LiamNmbr1/2-Factor-Auth-Lock/Assem1.SLDASM

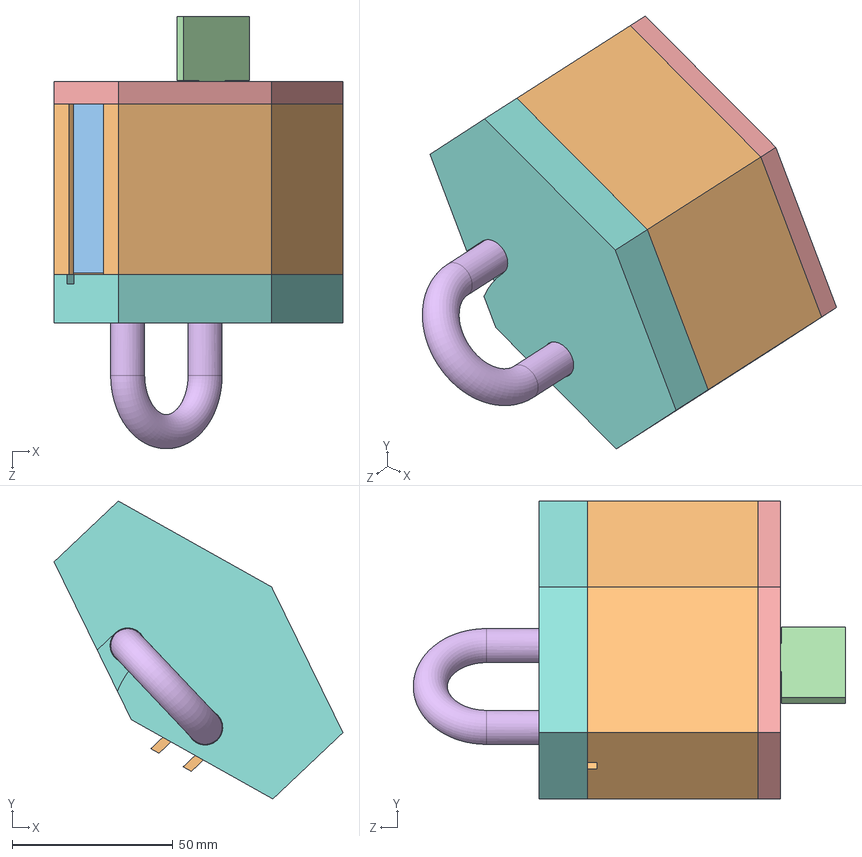
[picture p1: CAD file, 2026-10-18]
Assem1.SLDASM
89.8 x 92.6 x 134.3 mm
primary_rotator
secondary_rotator
Casing
plug_secondary_rotator
Cap_shackle
Slider_shackle
Shackle
Keyhole_cap
Key to unlock
Spring_cap
Shackle_pins
Pin_4mm
