LiamNmbr1/2-Factor-Auth-Lock/Shackle.SLDPRT

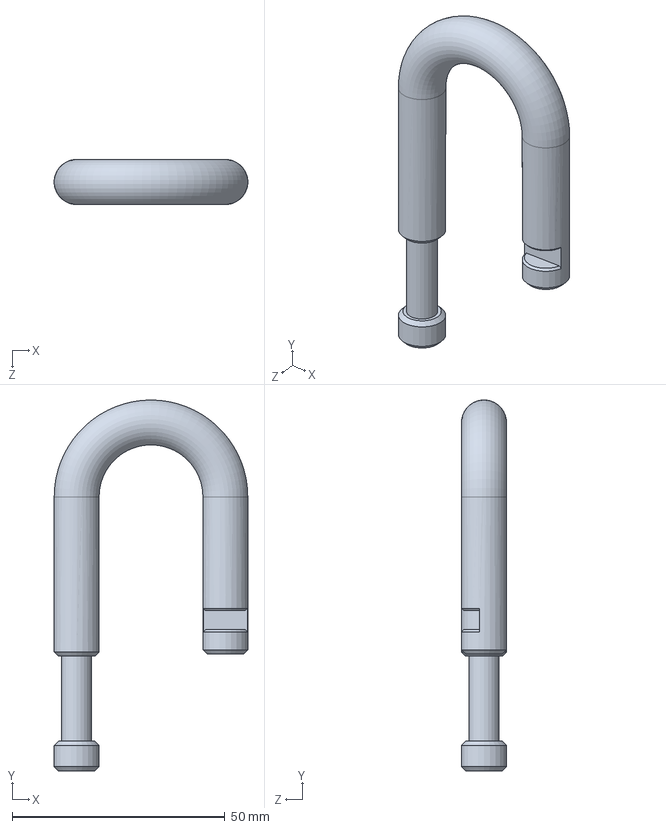
[picture p2: CAD file, 2026-10-18]
Shackle.SLDPRT
45.6 x 87.3 x 10.6 mm
