LiamNmbr1/2-Factor-Auth-Lock/Slider_shackle.SLDPRT

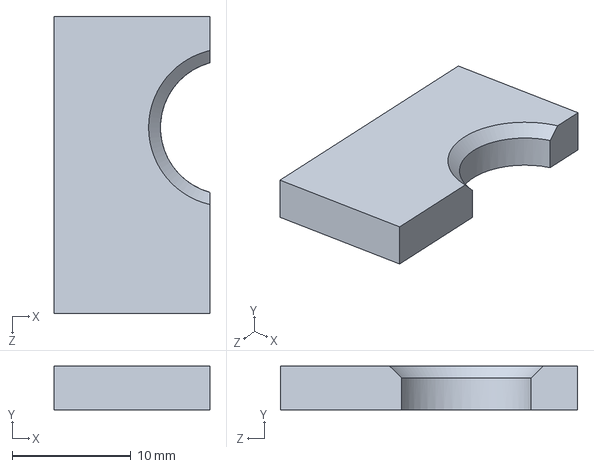
[picture p3: CAD file, 2026-10-18]
Slider_shackle.SLDPRT
13.1 x 3.70 x 25.0 mm
