LiamNmbr1/2-Factor-Auth-Lock/Pin_4mm.SLDPRT

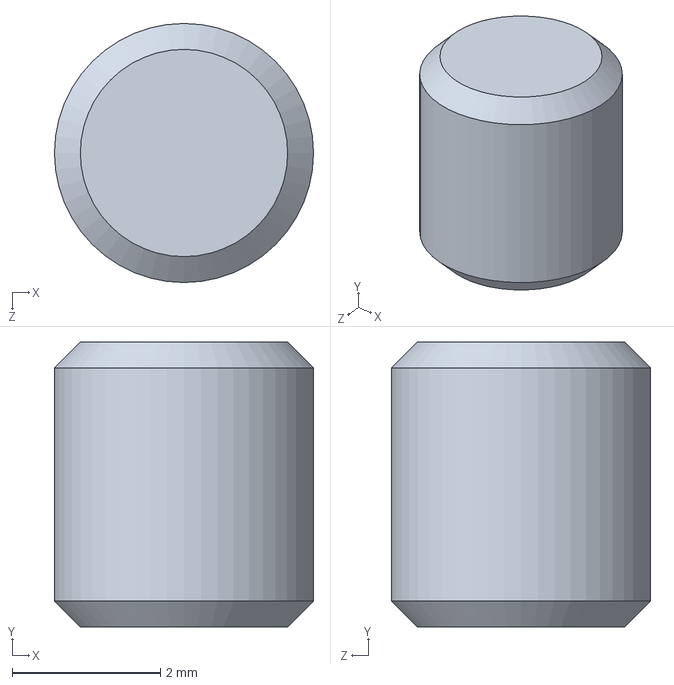
[picture p4: CAD file, 2026-10-18]
Pin_4mm.SLDPRT
3.50 x 3.85 x 3.50 mm
