LiamNmbr1/2-Factor-Auth-Lock/secondary_rotator.SLDPRT

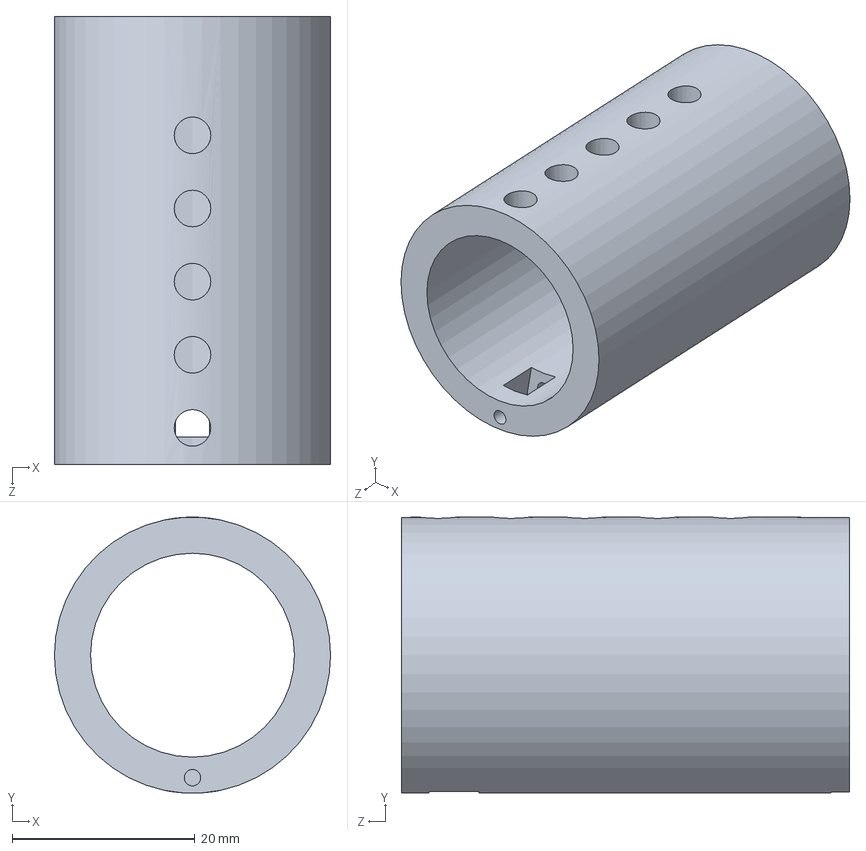
[picture p5: CAD file, 2026-10-18]
secondary_rotator.SLDPRT
30.2 x 30.2 x 49.0 mm
