LiamNmbr1/2-Factor-Auth-Lock/primary_piece_rotator.SLDPRT

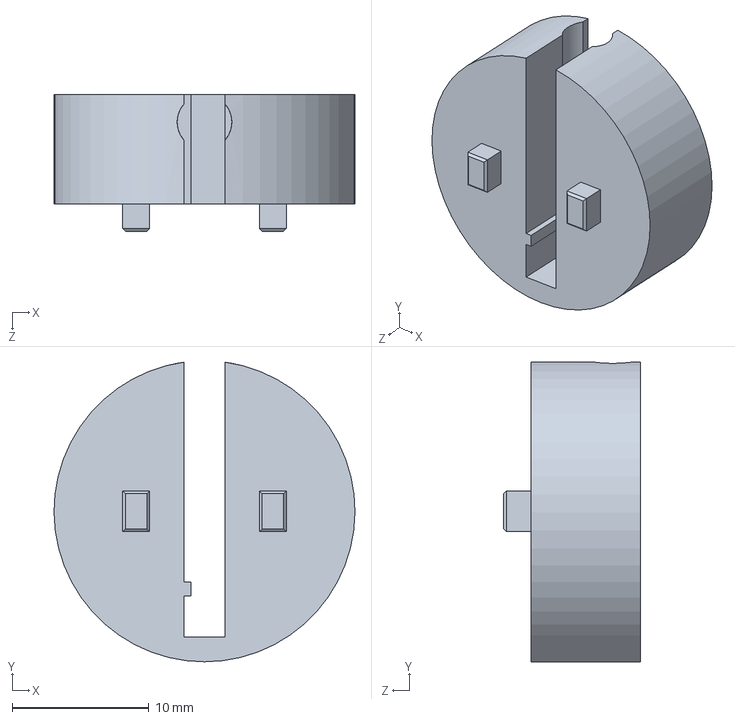
[picture p6: CAD file, 2026-10-18]
primary_piece_rotator.SLDPRT
22.0 x 21.9 x 9.98 mm
