LiamNmbr1/2-Factor-Auth-Lock/Cap_shackle.SLDPRT

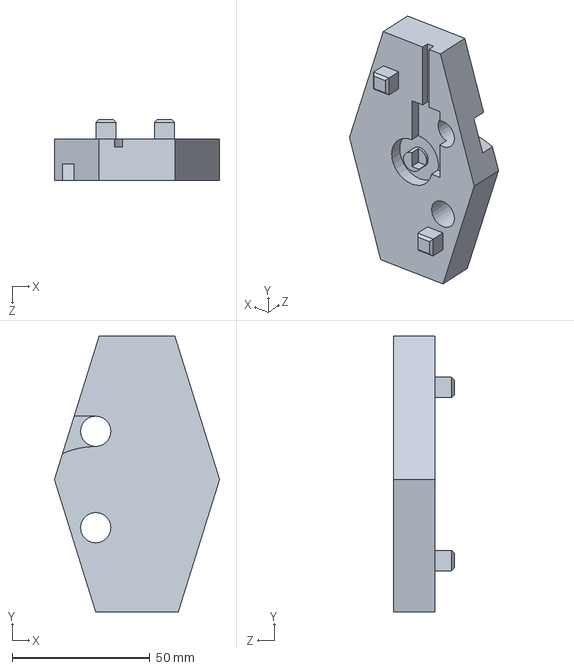
[picture p7: CAD file, 2026-10-18]
Cap_shackle.SLDPRT
60.0 x 100.2 x 22.0 mm
