LiamNmbr1/2-Factor-Auth-Lock/primary_rotator.SLDPRT

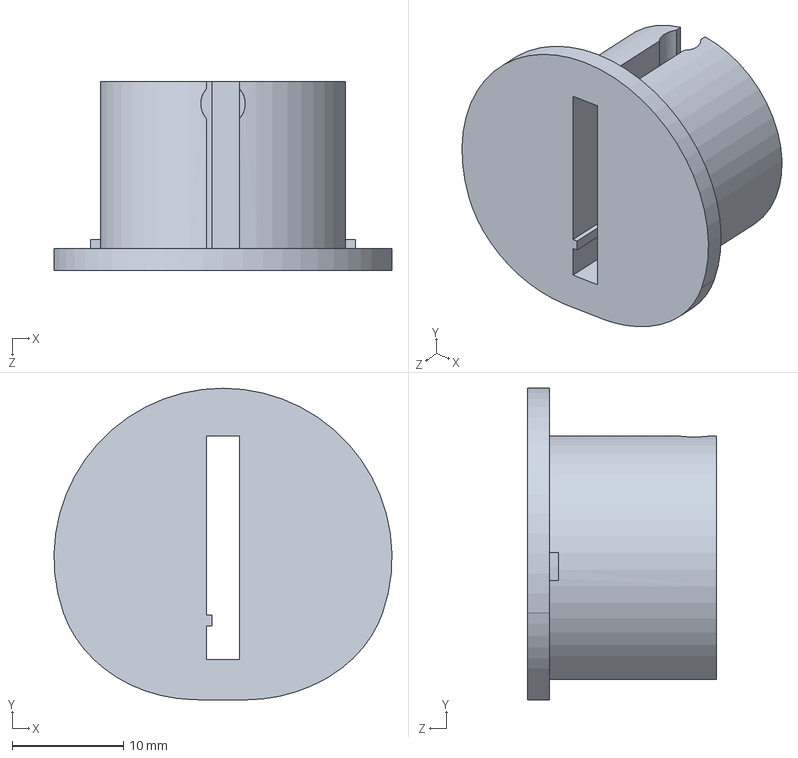
[picture p8: CAD file, 2026-10-18]
primary_rotator.SLDPRT
30.4 x 28.0 x 17.0 mm
