LiamNmbr1/2-Factor-Auth-Lock/Key to unlock.SLDPRT

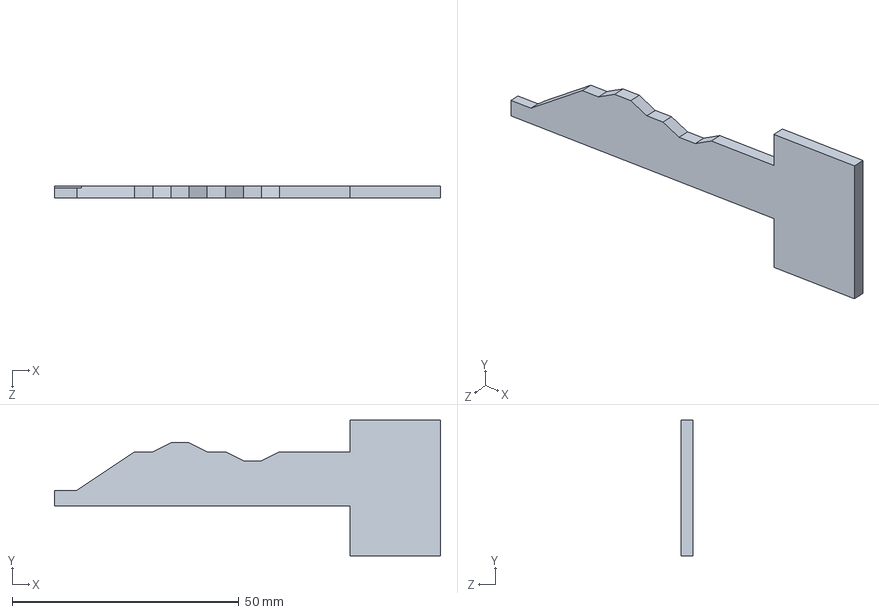
[picture p9: CAD file, 2026-10-18]
Key to unlock.SLDPRT
85.2 x 30.0 x 2.70 mm
