LiamNmbr1/2-Factor-Auth-Lock/Pin_6mm.SLDPRT

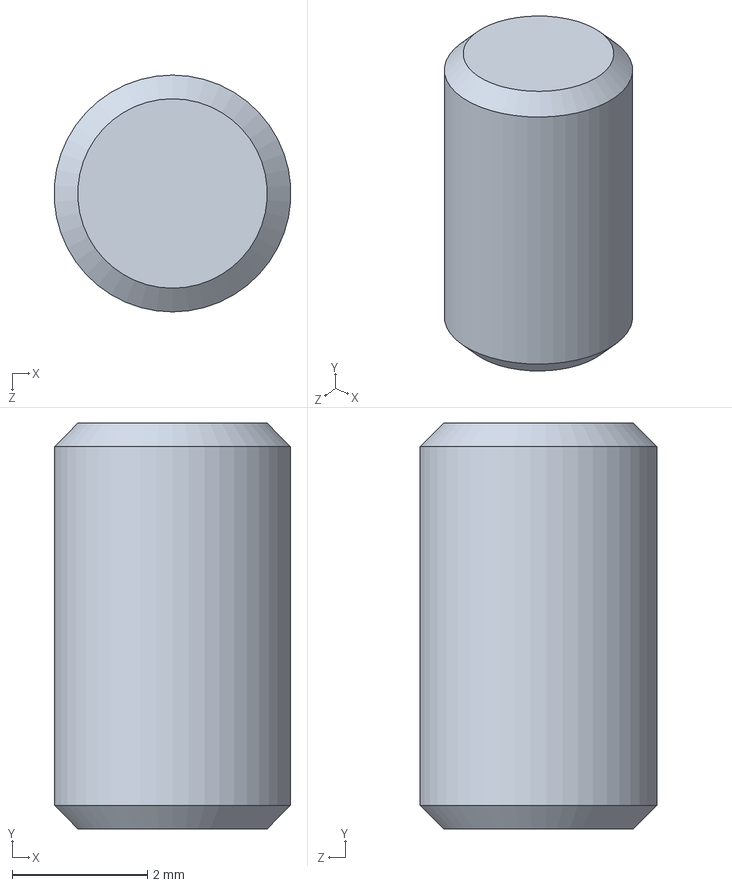
[picture p10: CAD file, 2026-10-18]
Pin_6mm.SLDPRT
3.49 x 6.00 x 3.50 mm
