LiamNmbr1/2-Factor-Auth-Lock/Spring_cap.SLDPRT

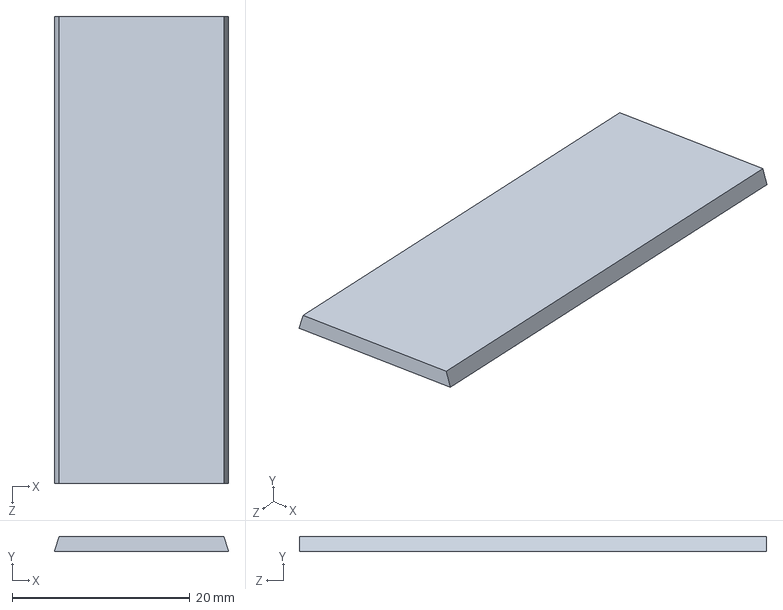
[picture p11: CAD file, 2026-10-18]
Spring_cap.SLDPRT
19.6 x 1.70 x 52.5 mm
