LiamNmbr1/2-Factor-Auth-Lock/plug_secondary_rotator.SLDPRT

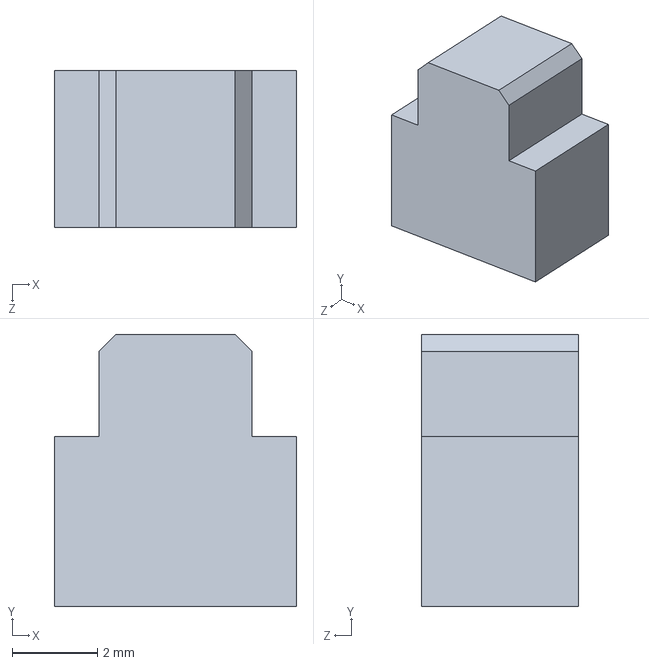
[picture p12: CAD file, 2026-10-18]
plug_secondary_rotator.SLDPRT
5.70 x 6.40 x 3.70 mm
