LiamNmbr1/2-Factor-Auth-Lock/Keyhole_cap.SLDPRT

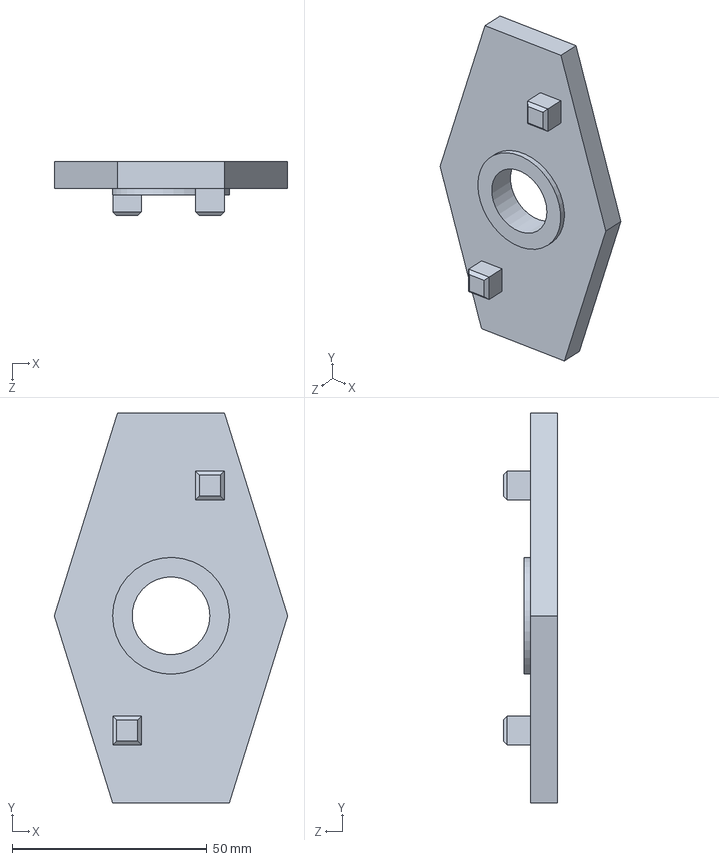
[picture p13: CAD file, 2026-10-18]
Keyhole_cap.SLDPRT
60.0 x 100.2 x 14.0 mm
