LiamNmbr1/2-Factor-Auth-Lock/Shackle_pins.SLDPRT

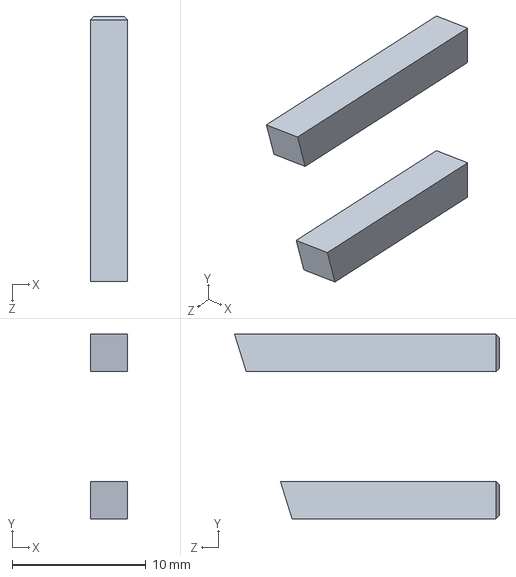
[picture p14: CAD file, 2026-10-18]
Shackle_pins.SLDPRT
2.80 x 13.8 x 19.8 mm
