LiamNmbr1/2-Factor-Auth-Lock/Casing.SLDPRT

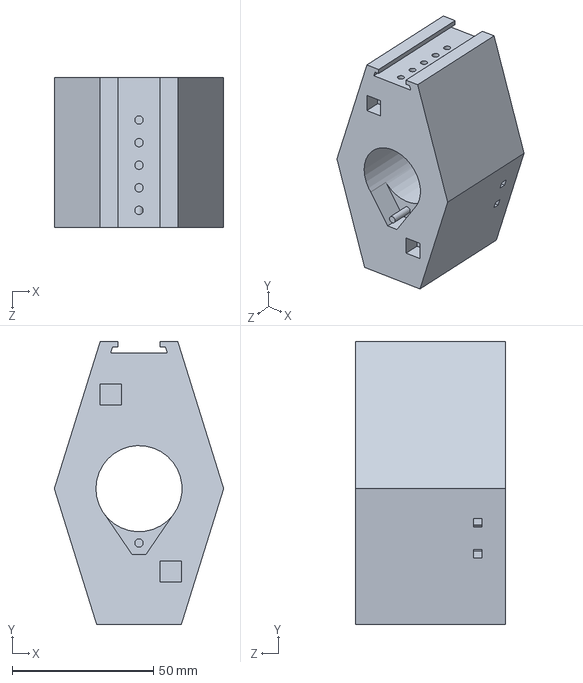
[picture p15: CAD file, 2026-10-18]
Casing.SLDPRT
60.0 x 100.2 x 53.0 mm
